hoglet67/HCRMicronPlus/kicad/micron_plus.pdf

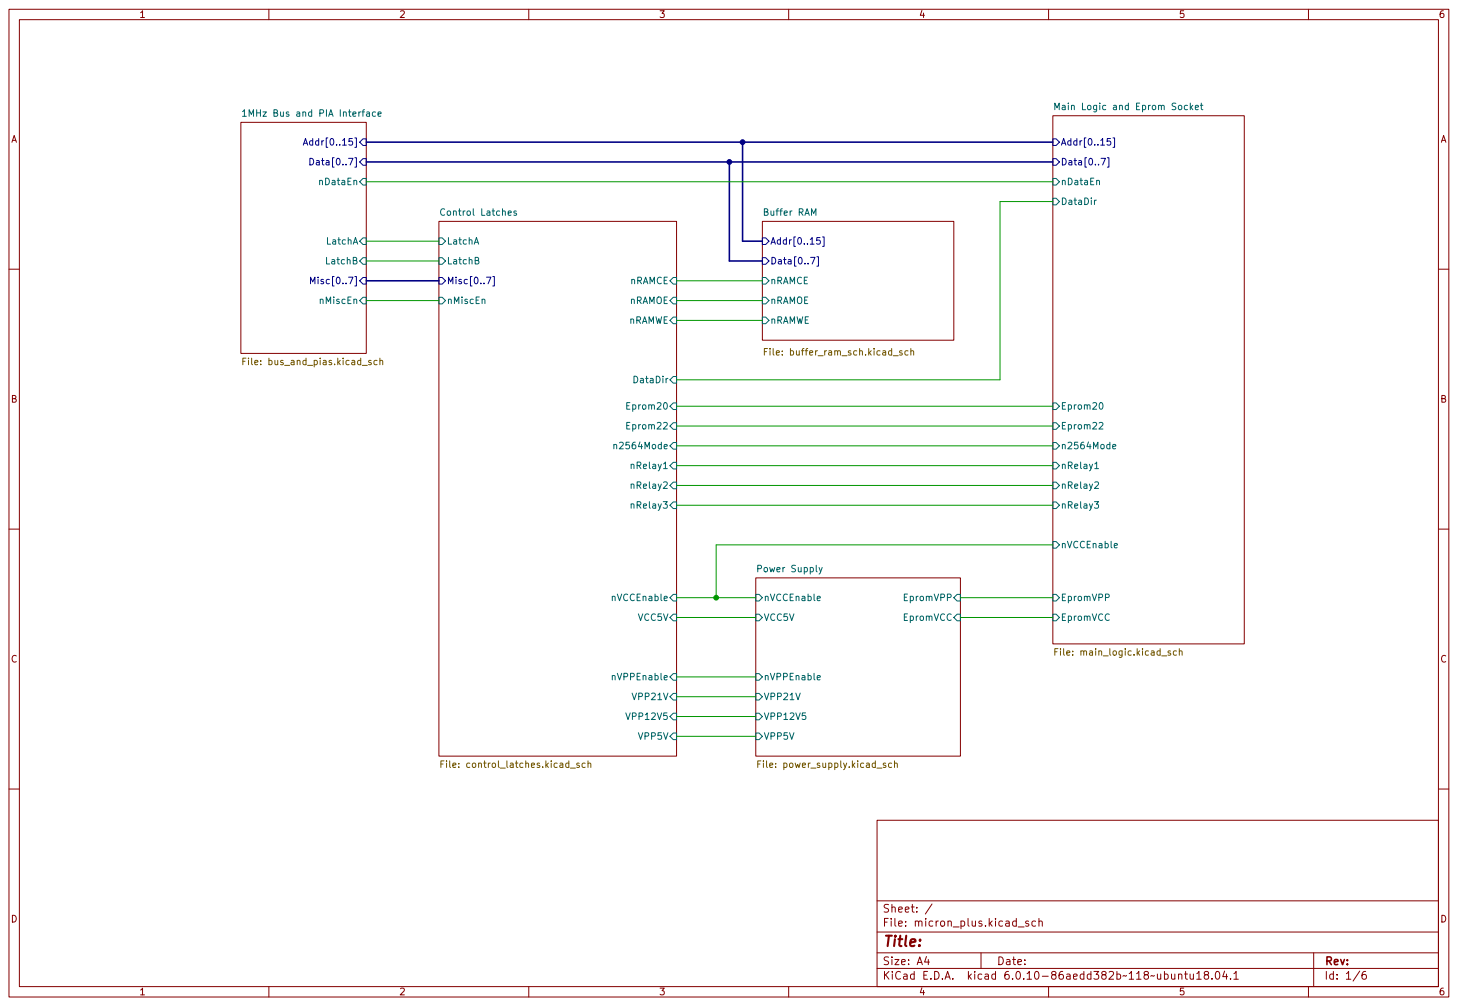
[picture p1: page 1]

nMiscEn Misc[0..7] 1MHz Bus and PIA Interface File: bus_and_pias.kicad_sch
Addr[0..15] nDataEn Data[0..7] LatchA
VCC5V Control Latches File: control_latches.kicad_sch

Main Logic and Eprom Socket
nVCCEnable DataDir n2564Mode

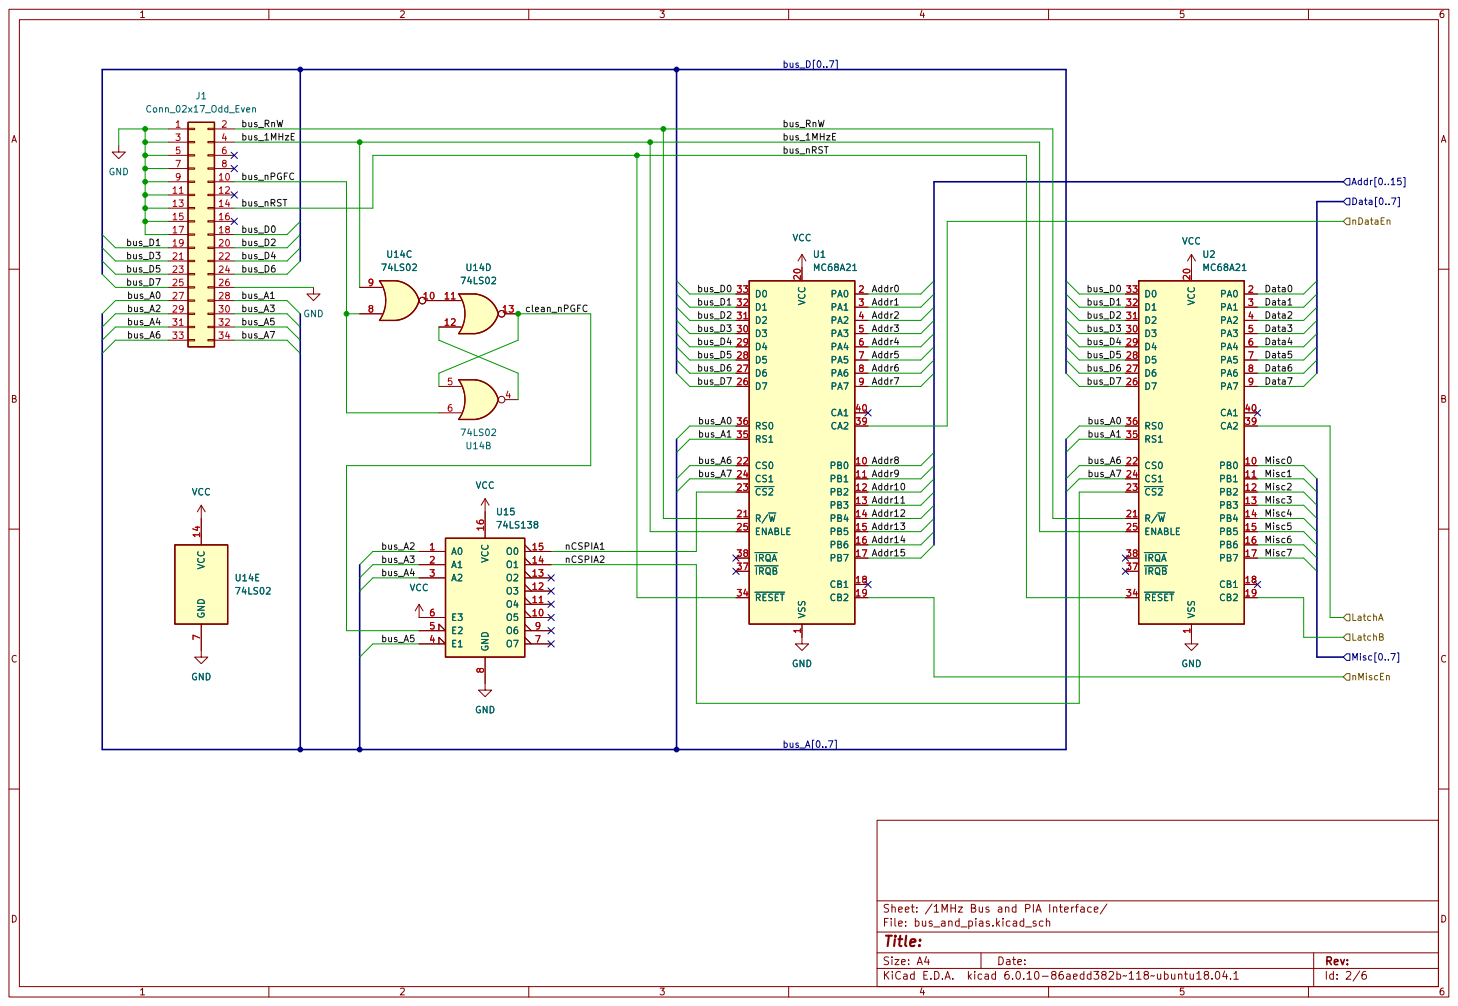
[picture p2: page 2]

bus_RnW

3 | | 4 bus_1MHzE | bus_1MHzE

File: bus_and_pias.kicad_sch Sheet: /1MHz Bus and PIA Interface/
Id: 2/6 Title:

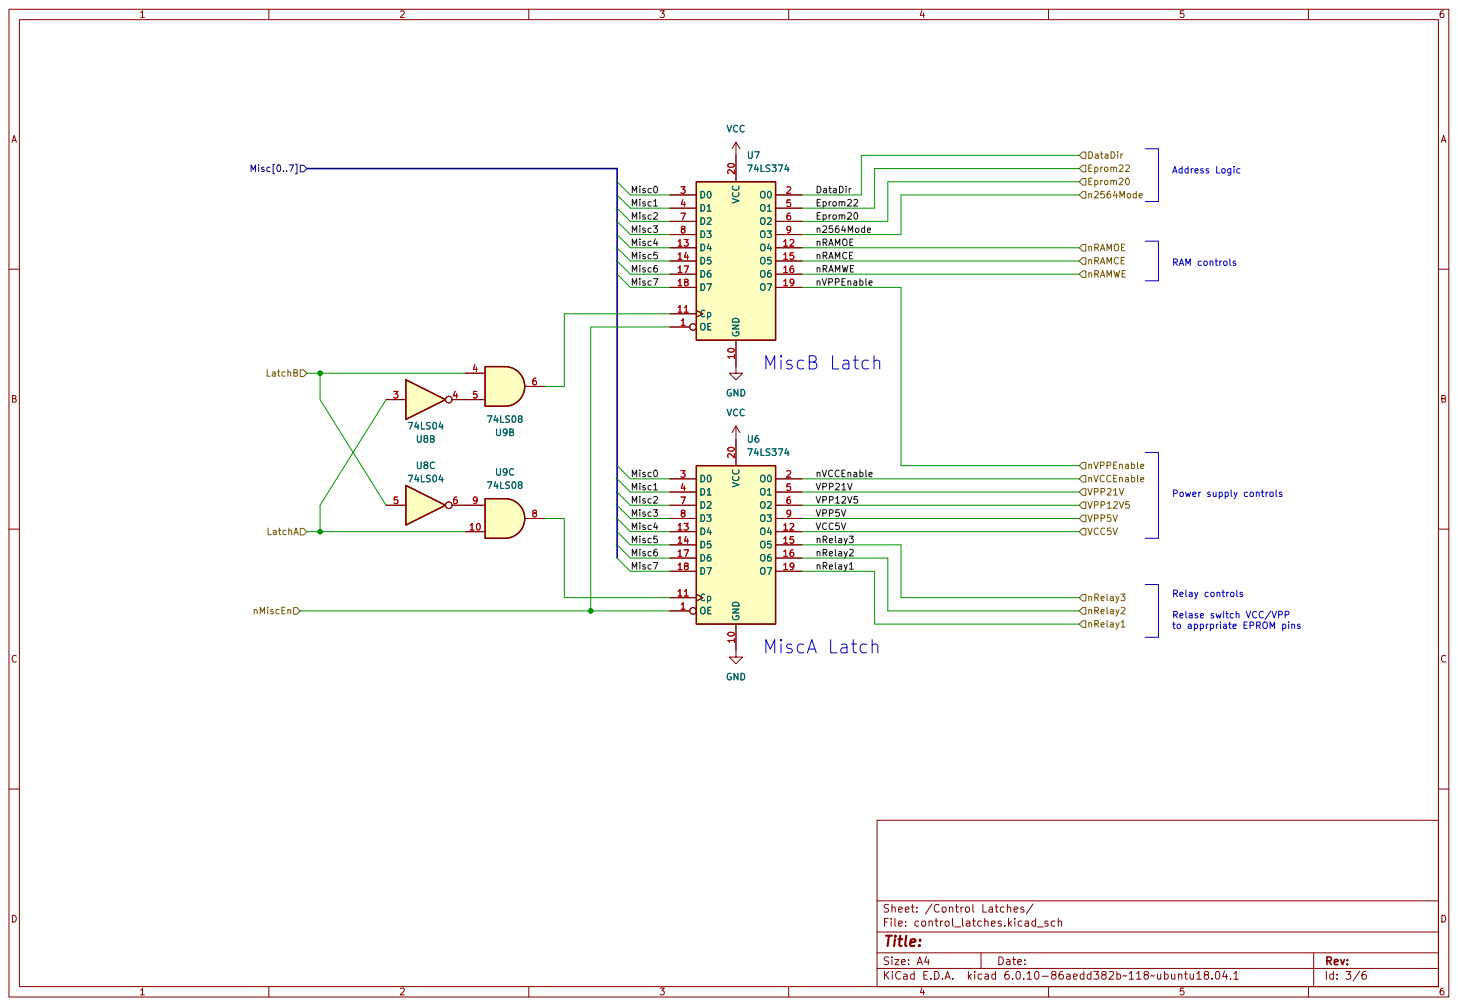
[picture p3: page 3]

RAM controls Address Logic VCC
74LS374 GND

Relay controls Relase switch VCC/VPP

to apprpriate EPROM pins

File: control_latches.kicad_sch Sheet: /Control Latches/
Id: 3/6 Title:

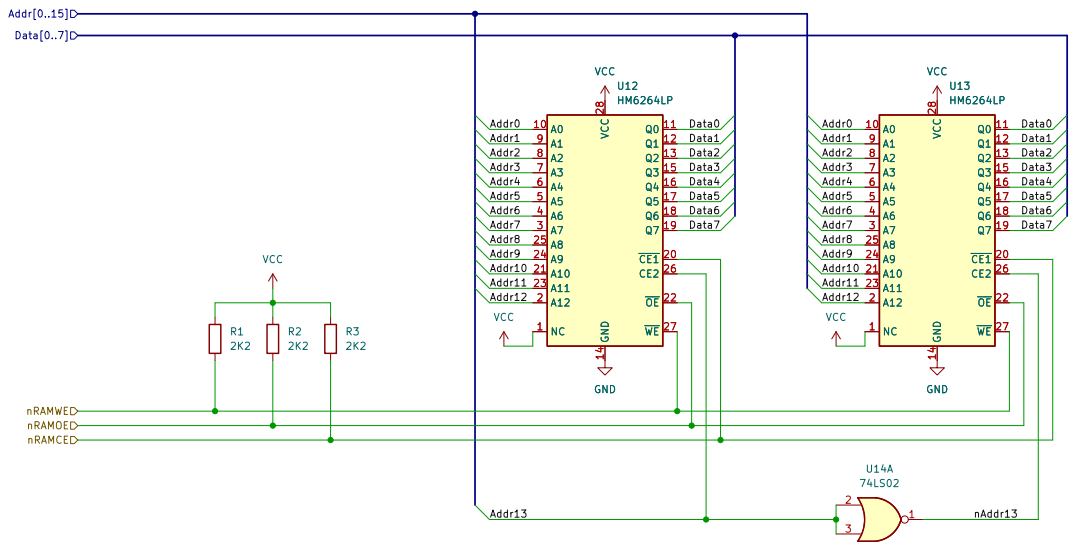
[picture p4: page 4]

File: buffer_ram_sch.kicad_sch Sheet: /Buffer RAM/
Id: 4/6 Title:

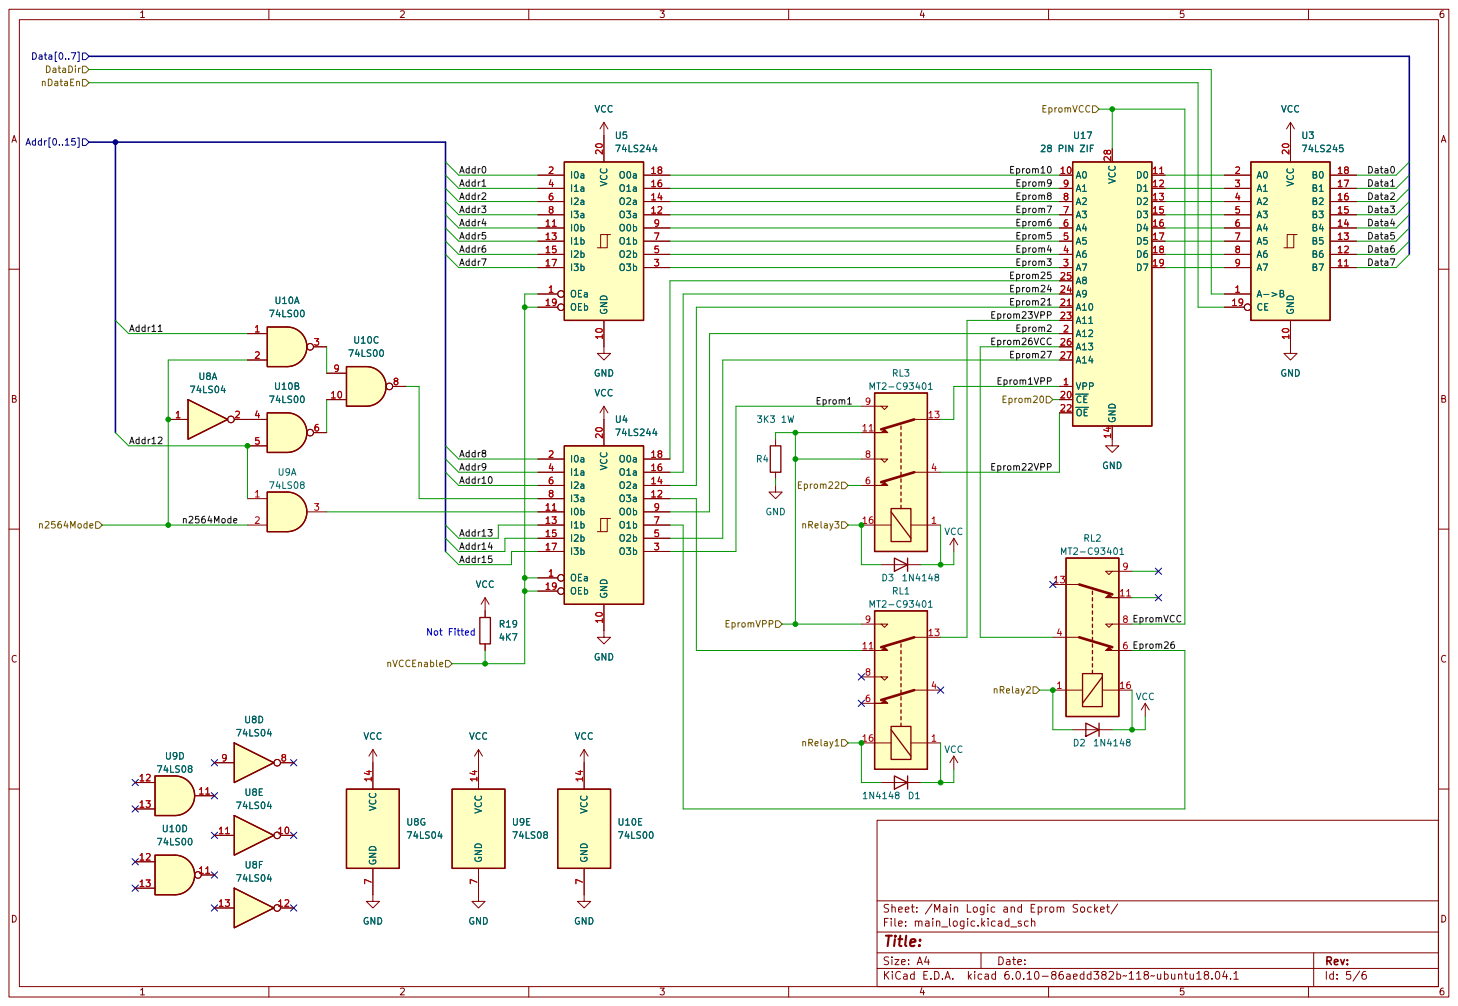
[picture p5: page 5]

Sheet: /Main Logic and Eprom Socket/
File: main_logic.kicad_sch
Id: 5/6 Title:

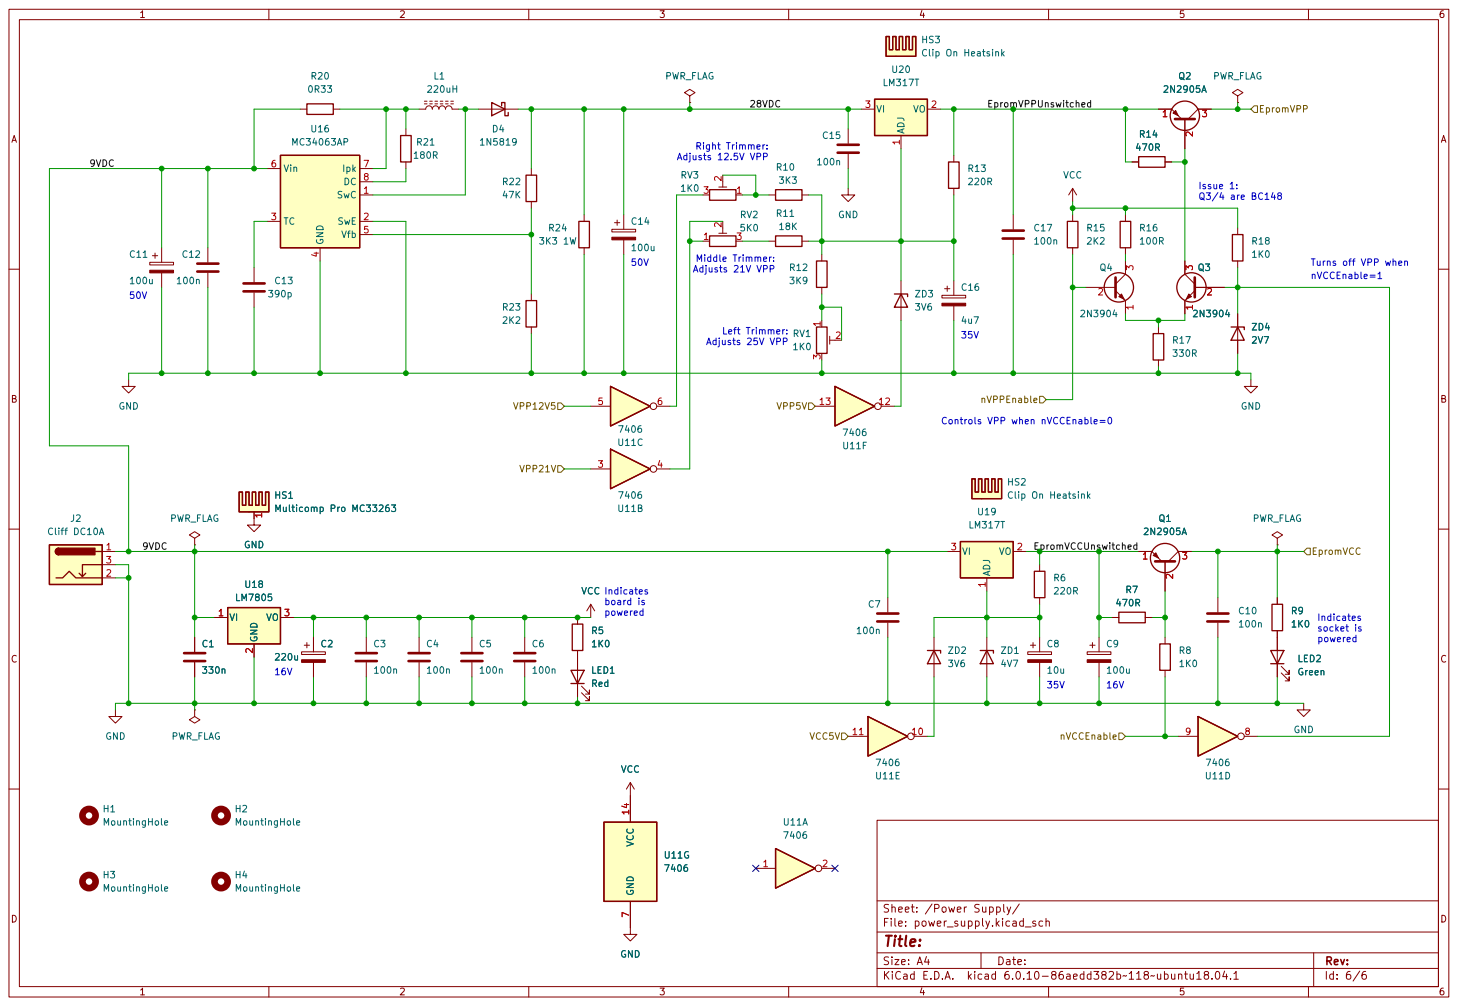
[picture p6: page 6]

Left Trimmer: Adjusts 25V VPP Middle Trimmer: Adjusts 21V VPP
