hoglet67/HCRMicronPlus/kicad/micron_plus.kicad_pcb

## KiCad design kicad/micron_plus.kicad_pcb (2023-11-20)

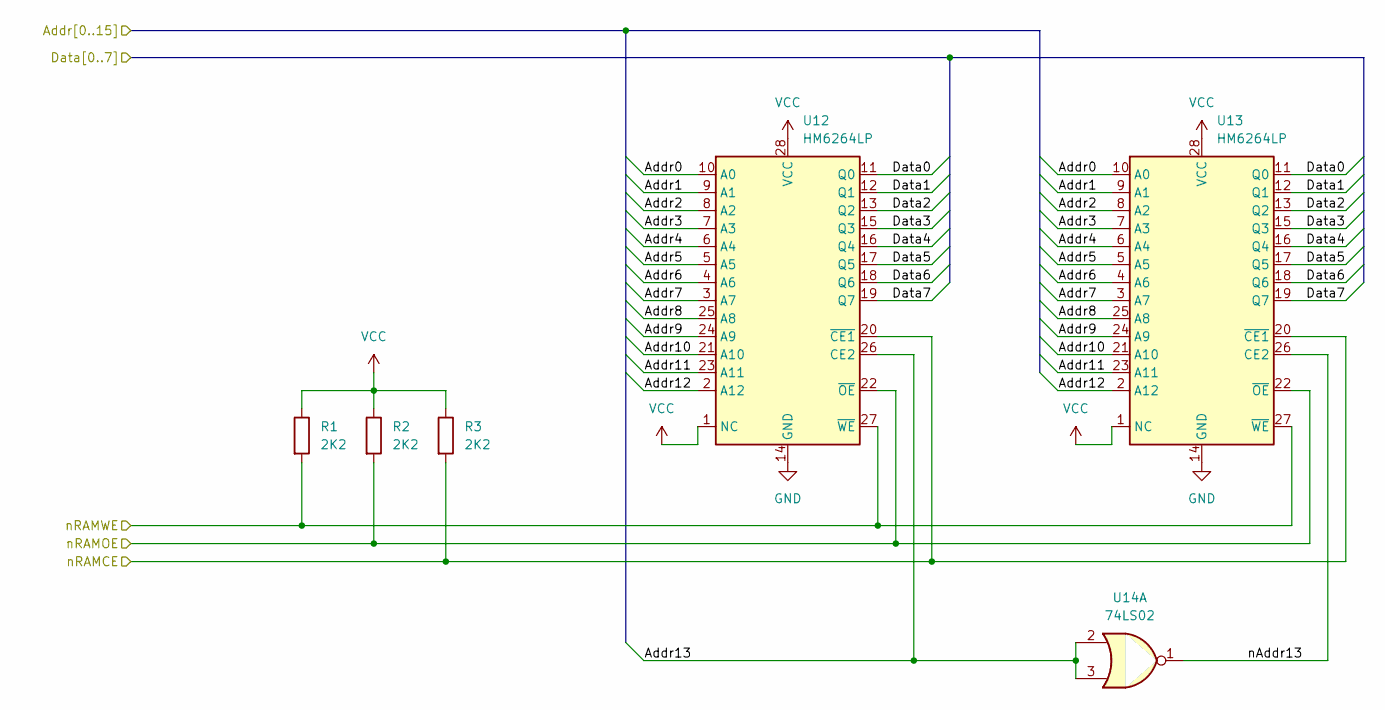
[picture p7: schematic buffer_ram_sch.kicad_sch]

Parts:
R1, R2, R3: 2K2; R_Axial_DIN0207_L6.3mm_D2.0mm_P10.16mm_Horizontal
U12, U13: HM6264LP; DIP-28_W15.24mm_Socket
U14: 74LS02; DIP-14_W7.62mm_Socket

Connections:
/1MHz Bus and PIA Interface/Addr0: U12.10 (A0), U13.10 (A0); also elsewhere on the board
/1MHz Bus and PIA Interface/Addr1: U12.9 (A1), U13.9 (A1); also elsewhere on the board
/1MHz Bus and PIA Interface/Addr2: U12.8 (A2), U13.8 (A2); also elsewhere on the board
/1MHz Bus and PIA Interface/Addr3: U12.7 (A3), U13.7 (A3); also elsewhere on the board
/1MHz Bus and PIA Interface/Addr4: U12.6 (A4), U13.6 (A4); also elsewhere on the board
/1MHz Bus and PIA Interface/Addr5: U12.5 (A5), U13.5 (A5); also elsewhere on the board
/1MHz Bus and PIA Interface/Addr6: U12.4 (A6), U13.4 (A6); also elsewhere on the board
/1MHz Bus and PIA Interface/Addr7: U12.3 (A7), U13.3 (A7); also elsewhere on the board
/1MHz Bus and PIA Interface/Addr8: U12.25 (A8), U13.25 (A8); also elsewhere on the board
/1MHz Bus and PIA Interface/Addr9: U12.24 (A9), U13.24 (A9); also elsewhere on the board
/1MHz Bus and PIA Interface/Addr10: U12.21 (A10), U13.21 (A10); also elsewhere on the board
/1MHz Bus and PIA Interface/Addr11: U12.23 (A11), U13.23 (A11); also elsewhere on the board
/1MHz Bus and PIA Interface/Addr12: U12.2 (A12), U13.2 (A12); also elsewhere on the board
/1MHz Bus and PIA Interface/Addr13: U12.26 (CE2), U14.2, U14.3; also elsewhere on the board
/1MHz Bus and PIA Interface/Data0: U12.11 (Q0), U13.11 (Q0); also elsewhere on the board
/1MHz Bus and PIA Interface/Data1: U12.12 (Q1), U13.12 (Q1); also elsewhere on the board
/1MHz Bus and PIA Interface/Data2: U12.13 (Q2), U13.13 (Q2); also elsewhere on the board
/1MHz Bus and PIA Interface/Data3: U12.15 (Q3), U13.15 (Q3); also elsewhere on the board
/1MHz Bus and PIA Interface/Data4: U12.16 (Q4), U13.16 (Q4); also elsewhere on the board
/1MHz Bus and PIA Interface/Data5: U12.17 (Q5), U13.17 (Q5); also elsewhere on the board
/1MHz Bus and PIA Interface/Data6: U12.18 (Q6), U13.18 (Q6); also elsewhere on the board
/1MHz Bus and PIA Interface/Data7: U12.19 (Q7), U13.19 (Q7); also elsewhere on the board
/Buffer RAM/nAddr13: U13.26 (CE2), U14.1
/Control Latches/nRAMCE: R3.2, U12.20 (~CE1), U13.20 (~CE1); also elsewhere on the board
/Control Latches/nRAMOE: R2.2, U12.22 (~OE), U13.22 (~OE); also elsewhere on the board
/Control Latches/nRAMWE: R1.2, U12.27 (~WE), U13.27 (~WE); also elsewhere on the board
GND: U12.14 (GND), U13.14 (GND); also elsewhere on the board
VCC: R1.1, R2.1, R3.1, U12.1 (NC), U12.28 (VCC), U13.1 (NC), U13.28 (VCC); also elsewhere on the board

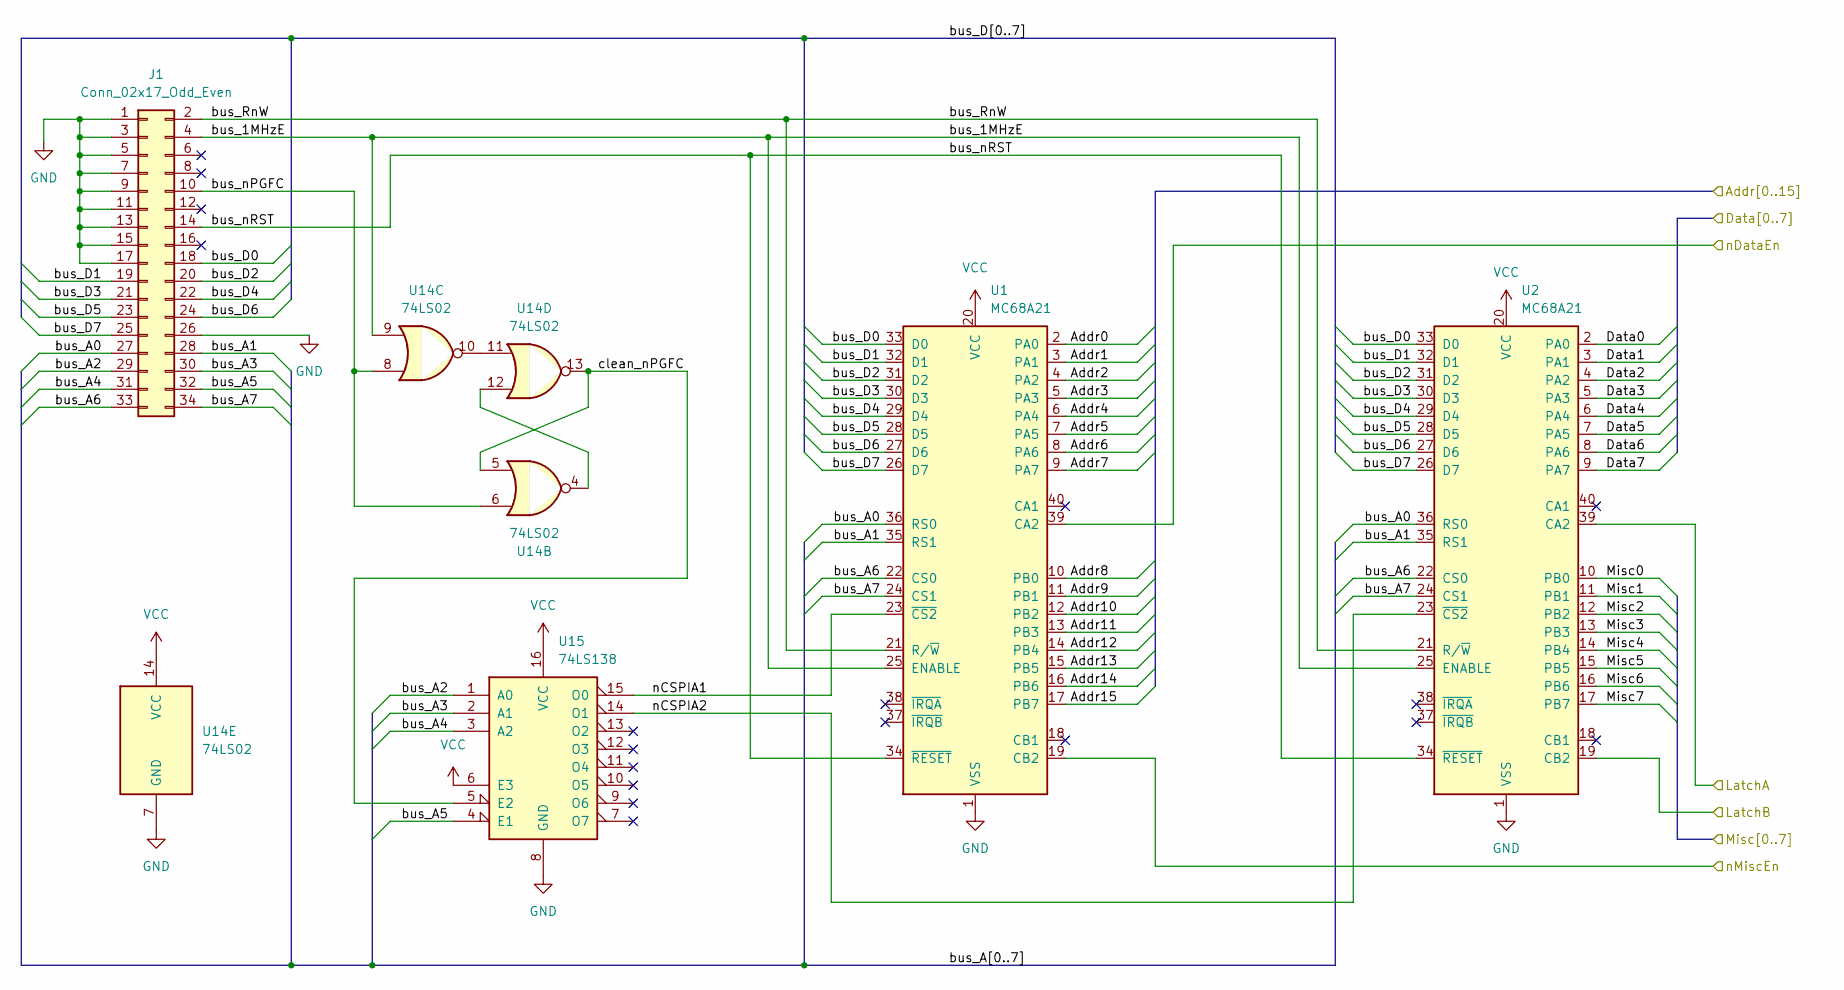
[picture p8: schematic bus_and_pias.kicad_sch]

Parts:
J1: Conn_02x17_Odd_Even; IDC-Header_2x17_P2.54mm_Vertical
U1, U2: MC68A21; DIP-40_W15.24mm_Socket
U14: 74LS02; DIP-14_W7.62mm_Socket
U15: 74LS138; DIP-16_W7.62mm_Socket

Connections:
/1MHz Bus and PIA Interface/Addr0: U1.2 (PA0); also elsewhere on the board
/1MHz Bus and PIA Interface/Addr1: U1.3 (PA1); also elsewhere on the board
/1MHz Bus and PIA Interface/Addr2: U1.4 (PA2); also elsewhere on the board
/1MHz Bus and PIA Interface/Addr3: U1.5 (PA3); also elsewhere on the board
/1MHz Bus and PIA Interface/Addr4: U1.6 (PA4); also elsewhere on the board
/1MHz Bus and PIA Interface/Addr5: U1.7 (PA5); also elsewhere on the board
/1MHz Bus and PIA Interface/Addr6: U1.8 (PA6); also elsewhere on the board
/1MHz Bus and PIA Interface/Addr7: U1.9 (PA7); also elsewhere on the board
/1MHz Bus and PIA Interface/Addr8: U1.10 (PB0); also elsewhere on the board
/1MHz Bus and PIA Interface/Addr9: U1.11 (PB1); also elsewhere on the board
/1MHz Bus and PIA Interface/Addr10: U1.12 (PB2); also elsewhere on the board
/1MHz Bus and PIA Interface/Addr11: U1.13 (PB3); also elsewhere on the board
/1MHz Bus and PIA Interface/Addr12: U1.14 (PB4); also elsewhere on the board
/1MHz Bus and PIA Interface/Addr13: U1.15 (PB5); also elsewhere on the board
/1MHz Bus and PIA Interface/Addr14: U1.16 (PB6); also elsewhere on the board
/1MHz Bus and PIA Interface/Addr15: U1.17 (PB7); also elsewhere on the board
/1MHz Bus and PIA Interface/Data0: U2.2 (PA0); also elsewhere on the board
/1MHz Bus and PIA Interface/Data1: U2.3 (PA1); also elsewhere on the board
/1MHz Bus and PIA Interface/Data2: U2.4 (PA2); also elsewhere on the board
/1MHz Bus and PIA Interface/Data3: U2.5 (PA3); also elsewhere on the board
/1MHz Bus and PIA Interface/Data4: U2.6 (PA4); also elsewhere on the board
/1MHz Bus and PIA Interface/Data5: U2.7 (PA5); also elsewhere on the board
/1MHz Bus and PIA Interface/Data6: U2.8 (PA6); also elsewhere on the board
/1MHz Bus and PIA Interface/Data7: U2.9 (PA7); also elsewhere on the board
/1MHz Bus and PIA Interface/LatchA: U2.39 (CA2); also elsewhere on the board
/1MHz Bus and PIA Interface/LatchB: U2.19 (CB2); also elsewhere on the board
/1MHz Bus and PIA Interface/Misc0: U2.10 (PB0); also elsewhere on the board
/1MHz Bus and PIA Interface/Misc1: U2.11 (PB1); also elsewhere on the board
/1MHz Bus and PIA Interface/Misc2: U2.12 (PB2); also elsewhere on the board
/1MHz Bus and PIA Interface/Misc3: U2.13 (PB3); also elsewhere on the board
/1MHz Bus and PIA Interface/Misc4: U2.14 (PB4); also elsewhere on the board
/1MHz Bus and PIA Interface/Misc5: U2.15 (PB5); also elsewhere on the board
/1MHz Bus and PIA Interface/Misc6: U2.16 (PB6); also elsewhere on the board
/1MHz Bus and PIA Interface/Misc7: U2.17 (PB7); also elsewhere on the board
/1MHz Bus and PIA Interface/bus_1MHzE: J1.4, U1.25 (ENABLE), U2.25 (ENABLE), U14.9
/1MHz Bus and PIA Interface/bus_A0: J1.27, U1.36 (RS0), U2.36 (RS0)
/1MHz Bus and PIA Interface/bus_A1: J1.28, U1.35 (RS1), U2.35 (RS1)
/1MHz Bus and PIA Interface/bus_A2: J1.29, U15.1 (A0)
/1MHz Bus and PIA Interface/bus_A3: J1.30, U15.2 (A1)
/1MHz Bus and PIA Interface/bus_A4: J1.31, U15.3 (A2)
/1MHz Bus and PIA Interface/bus_A5: J1.32, U15.4 (E1)
/1MHz Bus and PIA Interface/bus_A6: J1.33, U1.22 (CS0), U2.22 (CS0)
/1MHz Bus and PIA Interface/bus_A7: J1.34, U1.24 (CS1), U2.24 (CS1)
/1MHz Bus and PIA Interface/bus_D0: J1.18, U1.33 (D0), U2.33 (D0)
/1MHz Bus and PIA Interface/bus_D1: J1.19, U1.32 (D1), U2.32 (D1)
/1MHz Bus and PIA Interface/bus_D2: J1.20, U1.31 (D2), U2.31 (D2)
/1MHz Bus and PIA Interface/bus_D3: J1.21, U1.30 (D3), U2.30 (D3)
/1MHz Bus and PIA Interface/bus_D4: J1.22, U1.29 (D4), U2.29 (D4)
/1MHz Bus and PIA Interface/bus_D5: J1.23, U1.28 (D5), U2.28 (D5)
/1MHz Bus and PIA Interface/bus_D6: J1.24, U1.27 (D6), U2.27 (D6)
/1MHz Bus and PIA Interface/bus_D7: J1.25, U1.26 (D7), U2.26 (D7)
/1MHz Bus and PIA Interface/bus_RnW: J1.2, U1.21 (R/~W), U2.21 (R/~W)
/1MHz Bus and PIA Interface/bus_nPGFC: J1.10, U14.6, U14.8
/1MHz Bus and PIA Interface/bus_nRST: J1.14, U1.34 (~RESET), U2.34 (~RESET)
/1MHz Bus and PIA Interface/clean_nPGFC: U14.5, U14.13, U15.5 (E2)
/1MHz Bus and PIA Interface/nCSPIA1: U1.23 (~CS2), U15.15 (O0)
/1MHz Bus and PIA Interface/nCSPIA2: U2.23 (~CS2), U15.14 (O1)
/1MHz Bus and PIA Interface/nDataEn: U1.39 (CA2); also elsewhere on the board
/1MHz Bus and PIA Interface/nMiscEn: U1.19 (CB2); also elsewhere on the board
GND: J1.1, J1.3, J1.5, J1.7, J1.9, J1.11, J1.13, J1.15, J1.17, J1.26, U1.1 (VSS), U2.1 (VSS), U14.7 (GND), U15.8 (GND); also elsewhere on the board
unnamed: U14.10, U14.11
unnamed: U14.4, U14.12
VCC: U1.20 (VCC), U2.20 (VCC), U14.14 (VCC), U15.6 (E3), U15.16 (VCC); also elsewhere on the board

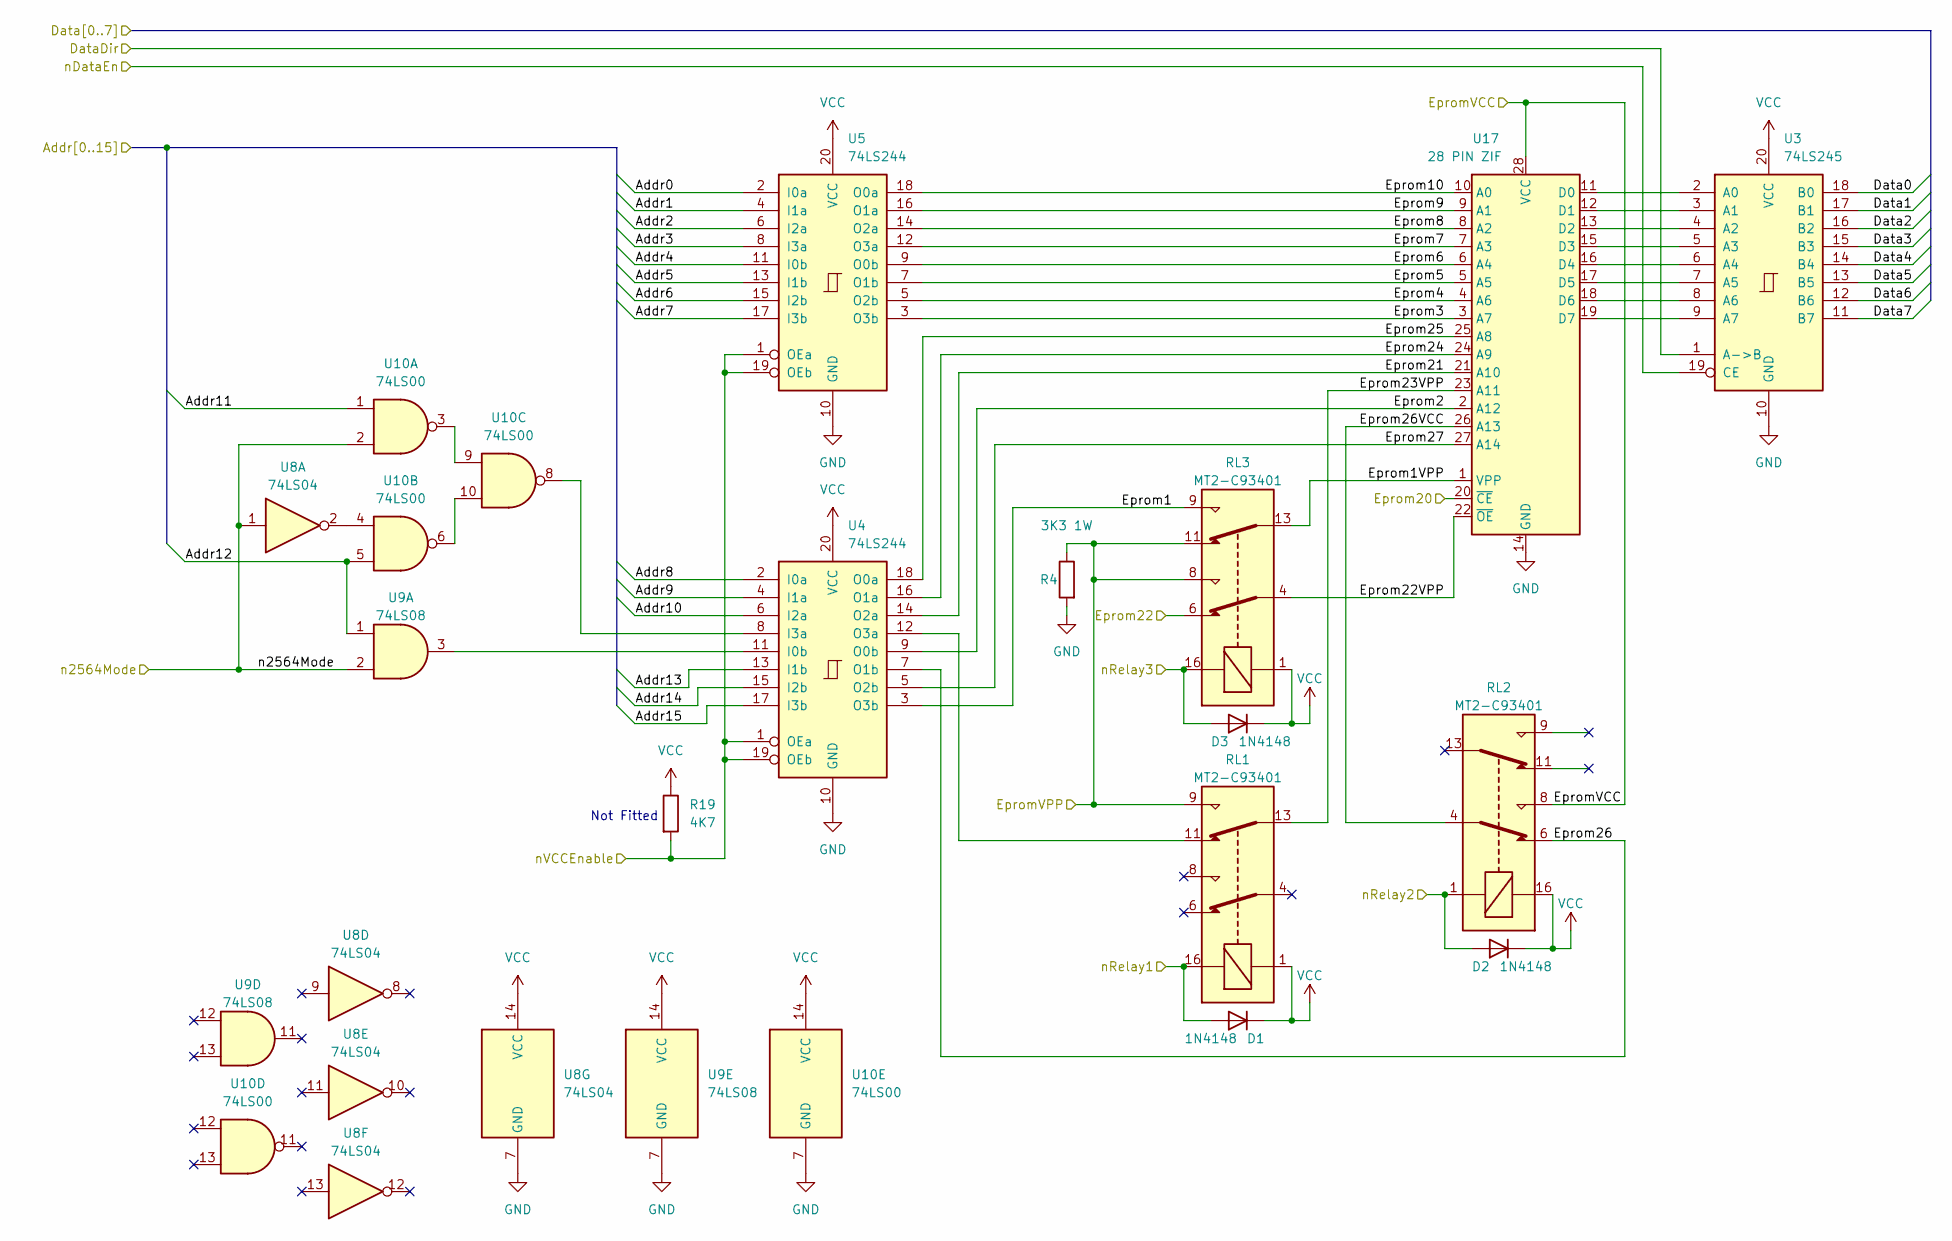
[picture p9: schematic main_logic.kicad_sch]

Parts:
D1, D2, D3: 1N4148; D_DO-35_SOD27_P11.43mm_Horizontal
R4: 3K3 1W; R_Axial_DIN0309_L9.0mm_D3.2mm_P12.70mm_Horizontal
R19: 4K7; R_Axial_DIN0207_L6.3mm_D2.0mm_P10.16mm_Horizontal
RL1, RL2, RL3: MT2-C93401; Relay_DPDT_Omron_G5V-2
U3: 74LS245; DIP-20_W7.62mm_Socket_tweaked
U4, U5: 74LS244; DIP-20_W7.62mm_Socket_tweaked
U8: 74LS04; DIP-14_W7.62mm_Socket
U9: 74LS08; DIP-14_W7.62mm_Socket
U10: 74LS00; DIP-14_W7.62mm_Socket
U17: 28 PIN ZIF; DIP_Socket-28_W11.9_W12.7_W15.24_W17.78_W18.5_3M_228-1277-0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

Connections:
/1MHz Bus and PIA Interface/Addr0: U5.2 (I0a); also elsewhere on the board
/1MHz Bus and PIA Interface/Addr1: U5.4 (I1a); also elsewhere on the board
/1MHz Bus and PIA Interface/Addr2: U5.6 (I2a); also elsewhere on the board
/1MHz Bus and PIA Interface/Addr3: U5.8 (I3a); also elsewhere on the board
/1MHz Bus and PIA Interface/Addr4: U5.11 (I0b); also elsewhere on the board
/1MHz Bus and PIA Interface/Addr5: U5.13 (I1b); also elsewhere on the board
/1MHz Bus and PIA Interface/Addr6: U5.15 (I2b); also elsewhere on the board
/1MHz Bus and PIA Interface/Addr7: U5.17 (I3b); also elsewhere on the board
/1MHz Bus and PIA Interface/Addr8: U4.2 (I0a); also elsewhere on the board
/1MHz Bus and PIA Interface/Addr9: U4.4 (I1a); also elsewhere on the board
/1MHz Bus and PIA Interface/Addr10: U4.6 (I2a); also elsewhere on the board
/1MHz Bus and PIA Interface/Addr11: U10.1; also elsewhere on the board
/1MHz Bus and PIA Interface/Addr12: U9.1, U10.5; also elsewhere on the board
/1MHz Bus and PIA Interface/Addr13: U4.13 (I1b); also elsewhere on the board
/1MHz Bus and PIA Interface/Addr14: U4.15 (I2b); also elsewhere on the board
/1MHz Bus and PIA Interface/Addr15: U4.17 (I3b); also elsewhere on the board
/1MHz Bus and PIA Interface/Data0: U3.18 (B0); also elsewhere on the board
/1MHz Bus and PIA Interface/Data1: U3.17 (B1); also elsewhere on the board
/1MHz Bus and PIA Interface/Data2: U3.16 (B2); also elsewhere on the board
/1MHz Bus and PIA Interface/Data3: U3.15 (B3); also elsewhere on the board
/1MHz Bus and PIA Interface/Data4: U3.14 (B4); also elsewhere on the board
/1MHz Bus and PIA Interface/Data5: U3.13 (B5); also elsewhere on the board
/1MHz Bus and PIA Interface/Data6: U3.12 (B6); also elsewhere on the board
/1MHz Bus and PIA Interface/Data7: U3.11 (B7); also elsewhere on the board
/1MHz Bus and PIA Interface/nDataEn: U3.19 (CE); also elsewhere on the board
/Control Latches/DataDir: U3.1 (A->B); also elsewhere on the board
/Control Latches/Eprom20: U17.20 (~CE); also elsewhere on the board
/Control Latches/Eprom22: RL3.6; also elsewhere on the board
/Control Latches/n2564Mode: U8.1, U9.2, U10.2; also elsewhere on the board
/Control Latches/nRelay1: D1.2 (A), RL1.16; also elsewhere on the board
/Control Latches/nRelay2: D2.2 (A), RL2.1; also elsewhere on the board
/Control Latches/nRelay3: D3.2 (A), RL3.16; also elsewhere on the board
/Control Latches/nVCCEnable: R19.2, U4.1 (OEa), U4.19 (OEb), U5.1 (OEa), U5.19 (OEb); also elsewhere on the board
/Main Logic and Eprom Socket/Eprom1: RL3.9, U4.3 (O3b)
/Main Logic and Eprom Socket/Eprom1VPP: RL3.13, U17.1 (VPP)
/Main Logic and Eprom Socket/Eprom2: U4.9 (O0b), U17.2 (A12)
/Main Logic and Eprom Socket/Eprom3: U5.3 (O3b), U17.3 (A7)
/Main Logic and Eprom Socket/Eprom4: U5.5 (O2b), U17.4 (A6)
/Main Logic and Eprom Socket/Eprom5: U5.7 (O1b), U17.5 (A5)
/Main Logic and Eprom Socket/Eprom6: U5.9 (O0b), U17.6 (A4)
/Main Logic and Eprom Socket/Eprom7: U5.12 (O3a), U17.7 (A3)
/Main Logic and Eprom Socket/Eprom8: U5.14 (O2a), U17.8 (A2)
/Main Logic and Eprom Socket/Eprom9: U5.16 (O1a), U17.9 (A1)
/Main Logic and Eprom Socket/Eprom10: U5.18 (O0a), U17.10 (A0)
/Main Logic and Eprom Socket/Eprom21: U4.14 (O2a), U17.21 (A10)
/Main Logic and Eprom Socket/Eprom22VPP: RL3.4, U17.22 (~OE)
/Main Logic and Eprom Socket/Eprom23VPP: RL1.13, U17.23 (A11)
/Main Logic and Eprom Socket/Eprom24: U4.16 (O1a), U17.24 (A9)
/Main Logic and Eprom Socket/Eprom25: U4.18 (O0a), U17.25 (A8)
/Main Logic and Eprom Socket/Eprom26: RL2.6, U4.7 (O1b)
/Main Logic and Eprom Socket/Eprom26VCC: RL2.4, U17.26 (A13)
/Main Logic and Eprom Socket/Eprom27: U4.5 (O2b), U17.27 (A14)
/Main Logic and Eprom Socket/EpromVCC: RL2.8, U17.28 (VCC); also elsewhere on the board
/Main Logic and Eprom Socket/EpromVPP: R4.1, RL1.9, RL3.8, RL3.11; also elsewhere on the board
GND: R4.2, U3.10 (GND), U4.10 (GND), U5.10 (GND), U8.7 (GND), U9.7 (GND), U10.7 (GND), U17.14 (GND); also elsewhere on the board
unnamed: RL1.11, U4.12 (O3a)
unnamed: U4.11 (I0b), U9.3
unnamed: U10.3, U10.9
unnamed: U8.2, U10.4
unnamed: U4.8 (I3a), U10.8
unnamed: U10.6, U10.10
unnamed: U3.2 (A0), U17.11 (D0)
unnamed: U3.3 (A1), U17.12 (D1)
unnamed: U3.4 (A2), U17.13 (D2)
unnamed: U3.5 (A3), U17.15 (D3)
unnamed: U3.6 (A4), U17.16 (D4)
unnamed: U3.7 (A5), U17.17 (D5)
unnamed: U3.8 (A6), U17.18 (D6)
unnamed: U3.9 (A7), U17.19 (D7)
VCC: D1.1 (K), D2.1 (K), D3.1 (K), R19.1, RL1.1, RL2.16, RL3.1, U3.20 (VCC), U4.20 (VCC), U5.20 (VCC), U8.14 (VCC), U9.14 (VCC), U10.14 (VCC); also elsewhere on the board

Notes on the sheet:
Not Fitted

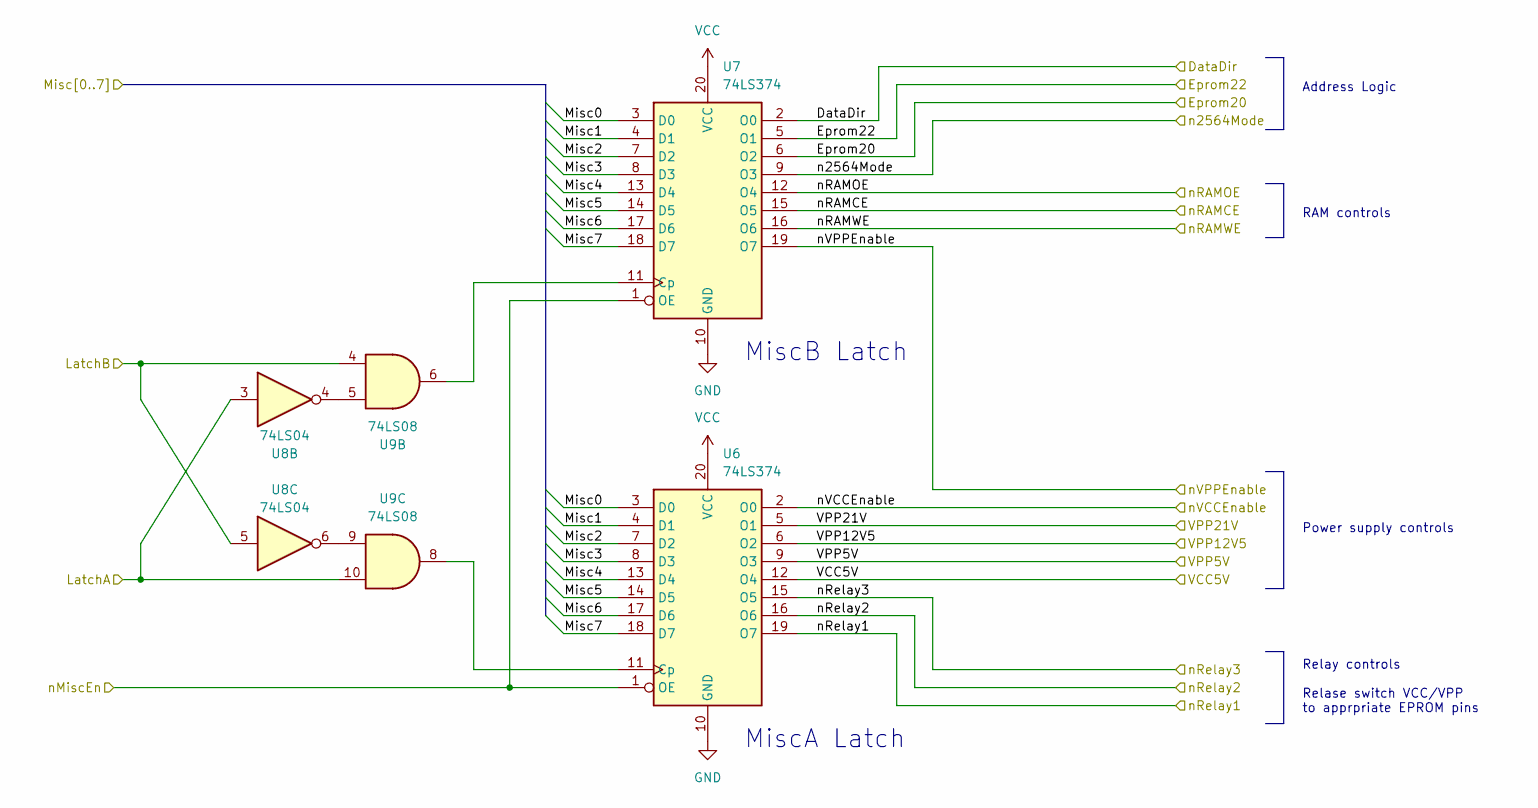
[picture p10: schematic control_latches.kicad_sch]

Parts:
U6, U7: 74LS374; DIP-20_W7.62mm_Socket
U8: 74LS04; DIP-14_W7.62mm_Socket
U9: 74LS08; DIP-14_W7.62mm_Socket

Connections:
/1MHz Bus and PIA Interface/LatchA: U8.3, U9.10; also elsewhere on the board
/1MHz Bus and PIA Interface/LatchB: U8.5, U9.4; also elsewhere on the board
/1MHz Bus and PIA Interface/Misc0: U6.3 (D0), U7.3 (D0); also elsewhere on the board
/1MHz Bus and PIA Interface/Misc1: U6.4 (D1), U7.4 (D1); also elsewhere on the board
/1MHz Bus and PIA Interface/Misc2: U6.7 (D2), U7.7 (D2); also elsewhere on the board
/1MHz Bus and PIA Interface/Misc3: U6.8 (D3), U7.8 (D3); also elsewhere on the board
/1MHz Bus and PIA Interface/Misc4: U6.13 (D4), U7.13 (D4); also elsewhere on the board
/1MHz Bus and PIA Interface/Misc5: U6.14 (D5), U7.14 (D5); also elsewhere on the board
/1MHz Bus and PIA Interface/Misc6: U6.17 (D6), U7.17 (D6); also elsewhere on the board
/1MHz Bus and PIA Interface/Misc7: U6.18 (D7), U7.18 (D7); also elsewhere on the board
/1MHz Bus and PIA Interface/nMiscEn: U6.1 (OE), U7.1 (OE); also elsewhere on the board
/Control Latches/DataDir: U7.2 (O0); also elsewhere on the board
/Control Latches/Eprom20: U7.6 (O2); also elsewhere on the board
/Control Latches/Eprom22: U7.5 (O1); also elsewhere on the board
/Control Latches/VCC5V: U6.12 (O4); also elsewhere on the board
/Control Latches/VPP5V: U6.9 (O3); also elsewhere on the board
/Control Latches/VPP12V5: U6.6 (O2); also elsewhere on the board
/Control Latches/VPP21V: U6.5 (O1); also elsewhere on the board
/Control Latches/n2564Mode: U7.9 (O3); also elsewhere on the board
/Control Latches/nRAMCE: U7.15 (O5); also elsewhere on the board
/Control Latches/nRAMOE: U7.12 (O4); also elsewhere on the board
/Control Latches/nRAMWE: U7.16 (O6); also elsewhere on the board
/Control Latches/nRelay1: U6.19 (O7); also elsewhere on the board
/Control Latches/nRelay2: U6.16 (O6); also elsewhere on the board
/Control Latches/nRelay3: U6.15 (O5); also elsewhere on the board
/Control Latches/nVCCEnable: U6.2 (O0); also elsewhere on the board
/Control Latches/nVPPEnable: U7.19 (O7); also elsewhere on the board
GND: U6.10 (GND), U7.10 (GND); also elsewhere on the board
unnamed: U6.11 (Cp), U9.8
unnamed: U7.11 (Cp), U9.6
unnamed: U8.4, U9.5
unnamed: U8.6, U9.9
VCC: U6.20 (VCC), U7.20 (VCC); also elsewhere on the board

Notes on the sheet:
RAM controls
Address Logic
Power supply controls
MiscA Latch
Relay controls Relase switch VCC/VPP to apprpriate EPROM pins
MiscB Latch

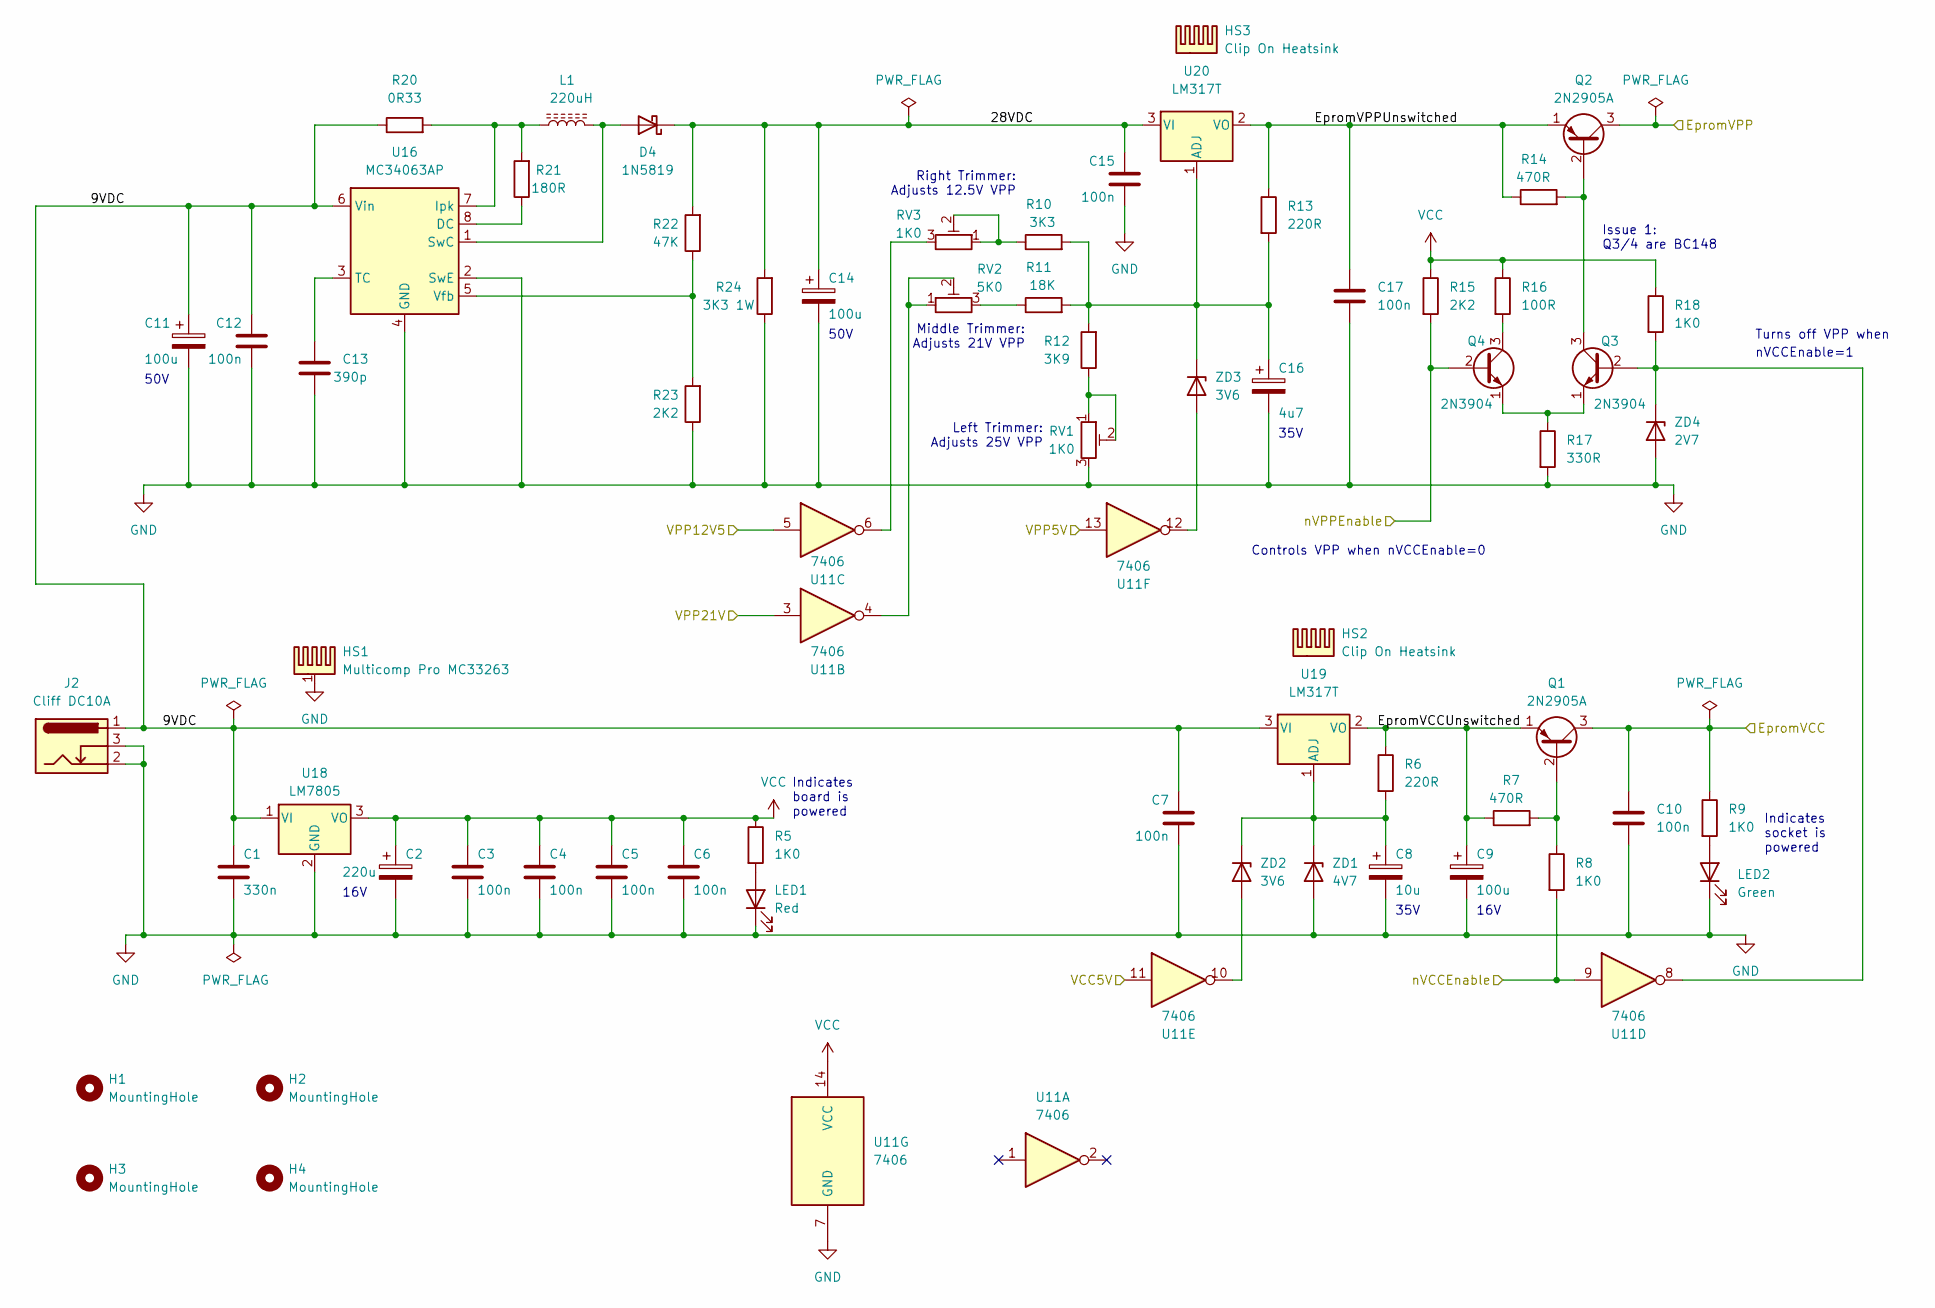
[picture p11: schematic power_supply.kicad_sch]

Parts:
C1: 330n; C_Disc_D4.3mm_W1.9mm_P5.00mm
C2: 220u; CP_Radial_D8.0mm_P5.00mm
C3, C4, C5, C6, C7, C10, C12, C15, C17: 100n; C_Disc_D4.3mm_W1.9mm_P5.00mm
C8: 10u; CP_Radial_Tantal_D4.5mm_P5.00mm
C9: 100u; CP_Radial_D6.3mm_P2.50mm
C11, C14: 100u; CP_Radial_D8.0mm_P5.00mm
C13: 390p; C_Disc_D4.3mm_W1.9mm_P5.00mm
C16: 4u7; CP_Radial_Tantal_D4.5mm_P5.00mm
D4: 1N5819; D_DO-41_SOD81_P10.16mm_Horizontal
H1, H2, H3, H4: MountingHole; MountingHole_3.2mm_M3
HS1: Multicomp Pro MC33263; Heatsink_Fischer_SK104-STC-STIC_35x13mm_2xDrill2.5mm
HS2, HS3: Clip On Heatsink; Heatsink_Boyd_PF720
J2: Cliff DC10A; CLIFF_FC68148(DC-10A)
L1: 220uH; L_Radial_D14.2mm_P10.00mm_Kemet
LED1: Red; LED_D3.0mm
LED2: Green; LED_D3.0mm
Q1, Q2: 2N2905A; TO-39-3
Q3, Q4: 2N3904; TO-92_Wide
R5, R9: 1K0; R_Axial_DIN0207_L6.3mm_D2.0mm_P10.16mm_Horizontal
R6, R13: 220R; R_Axial_DIN0207_L6.3mm_D2.0mm_P11.43mm_Horizontal
R7: 470R; R_Axial_DIN0207_L6.3mm_D2.0mm_P11.43mm_Horizontal
R8, R18: 1K0; R_Axial_DIN0207_L6.3mm_D2.0mm_P11.43mm_Horizontal
R10: 3K3; R_Axial_DIN0207_L6.3mm_D2.0mm_P11.43mm_Horizontal
R11: 18K; R_Axial_DIN0207_L6.3mm_D2.0mm_P11.43mm_Horizontal
R12: 3K9; R_Axial_DIN0207_L6.3mm_D2.0mm_P11.43mm_Horizontal
R14: 470R; R_Axial_DIN0207_L6.3mm_D2.0mm_P10.16mm_Horizontal
R15: 2K2; R_Axial_DIN0207_L6.3mm_D2.0mm_P11.43mm_Horizontal
R16: 100R; R_Axial_DIN0207_L6.3mm_D2.0mm_P11.43mm_Horizontal
R17: 330R; R_Axial_DIN0207_L6.3mm_D2.0mm_P11.43mm_Horizontal
R20: 0R33; R_Axial_DIN0207_L6.3mm_D2.5mm_P10.16mm_Horizontal
R21: 180R; R_Axial_DIN0207_L6.3mm_D2.0mm_P10.16mm_Horizontal
R22: 47K; R_Axial_DIN0207_L6.3mm_D2.0mm_P10.16mm_Horizontal
R23: 2K2; R_Axial_DIN0207_L6.3mm_D2.0mm_P10.16mm_Horizontal
R24: 3K3 1W; R_Axial_DIN0309_L9.0mm_D3.2mm_P12.70mm_Horizontal
RV1, RV3: 1K0; Potentiometer_Bourns_3296W_Vertical
RV2: 5K0; Potentiometer_Bourns_3296W_Vertical
U11: 7406; DIP-14_W7.62mm_Socket
U16: MC34063AP; DIP-8_W7.62mm_Socket
U18: LM7805; TO-220-3_Vertical
U19, U20: LM317T; TO-220-3_Vertical
ZD1: 4V7; D_DO-35_SOD27_P11.43mm_Horizontal
ZD2, ZD3: 3V6; D_DO-35_SOD27_P11.43mm_Horizontal
ZD4: 2V7; D_DO-35_SOD27_P11.43mm_Horizontal

Connections:
/Control Latches/VCC5V: U11.11; also elsewhere on the board
/Control Latches/VPP5V: U11.13; also elsewhere on the board
/Control Latches/VPP12V5: U11.5; also elsewhere on the board
/Control Latches/VPP21V: U11.3; also elsewhere on the board
/Control Latches/nVCCEnable: R8.2, U11.9; also elsewhere on the board
/Control Latches/nVPPEnable: Q4.2 (B), R15.2; also elsewhere on the board
/Main Logic and Eprom Socket/EpromVCC: C10.1, Q1.3 (C), R9.1; also elsewhere on the board
/Main Logic and Eprom Socket/EpromVPP: Q2.3 (C); also elsewhere on the board
/Power Supply/9VDC: C1.1, C7.1, C11.1, C12.1, J2.1, R20.1, U16.6 (Vin), U18.1 (VI), U19.3 (VI)
/Power Supply/28VDC: C14.1, C15.1, D4.1 (K), R22.2, R24.2, U20.3 (VI)
/Power Supply/EpromVCCUnswitched: C9.1, Q1.1 (E), R6.1, R7.1, U19.2 (VO)
/Power Supply/EpromVPPUnswitched: C17.1, Q2.1 (E), R13.1, R14.1, U20.2 (VO)
GND: C1.2, C2.2, C3.2, C4.2, C5.2, C6.2, C7.2, C8.2, C9.2, C10.2, C11.2, C12.2, C13.2, C14.2, C15.2, C16.2, C17.2, HS1.1, J2.2, J2.3, LED1.1 (K), LED2.1 (K), R17.2, R23.1, R24.1, RV1.3, U11.7 (GND), U16.2 (SwE), U16.4 (GND), U18.2 (GND), ZD1.2 (A), ZD4.2 (A); also elsewhere on the board
unnamed: C8.1, R6.2, U19.1 (ADJ), ZD1.1 (K), ZD2.1 (K)
unnamed: C13.1, U16.3 (TC)
unnamed: C16.1, R10.2, R11.2, R12.2, R13.2, U20.1 (ADJ), ZD3.1 (K)
unnamed: D4.2 (A), L1.2, U16.1 (SwC)
unnamed: L1.1, R20.2, R21.2, U16.7 (Ipk)
unnamed: LED1.2 (A), R5.2
unnamed: LED2.2 (A), R9.2
unnamed: Q1.2 (B), R7.2, R8.1
unnamed: Q2.2 (B), Q3.3 (C), R14.2
unnamed: Q3.1 (E), Q4.1 (E), R17.1
unnamed: Q3.2 (B), R18.2, U11.8, ZD4.1 (K)
unnamed: Q4.3 (C), R16.2
unnamed: R10.1, RV3.1, RV3.2
unnamed: R11.1, RV2.3
unnamed: R12.1, RV1.1, RV1.2
unnamed: R21.1, U16.8 (DC)
unnamed: R22.1, R23.2, U16.5 (Vfb)
unnamed: RV2.1, RV2.2, U11.4
unnamed: RV3.3, U11.6
unnamed: U11.10, ZD2.2 (A)
unnamed: U11.12, ZD3.2 (A)
VCC: C2.1, C3.1, C4.1, C5.1, C6.1, R5.1, R15.1, R16.1, R18.1, U11.14 (VCC), U18.3 (VO); also elsewhere on the board

Notes on the sheet:
Left Trimmer: Adjusts 25V VPP
16V
50V
Indicates socket is powered
35V
Indicates board is powered
Controls VPP when nVCCEnable=0
Turns off VPP when
Right Trimmer: Adjusts 12.5V VPP
Middle Trimmer: Adjusts 21V VPP
nVCCEnable=1
Issue 1: Q3/4 are BC148
