hoglet67/HCRMicronPlus/kicad/micron_plus.kicad_pcb

## KiCad design kicad/micron_plus.kicad_pcb (continued)

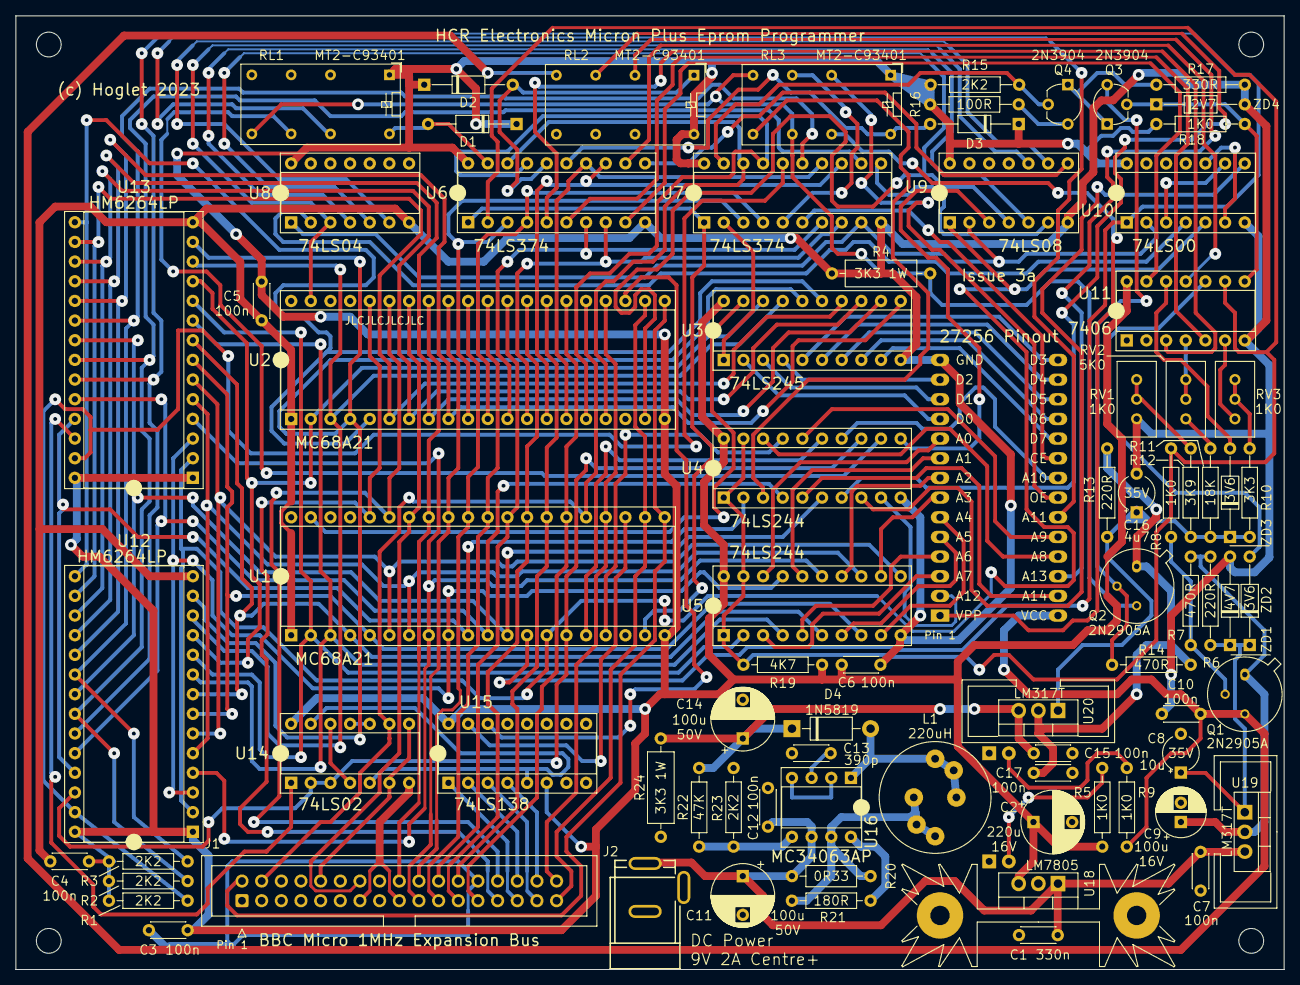
[picture p12: board micron_plus.kicad_pcb from above]

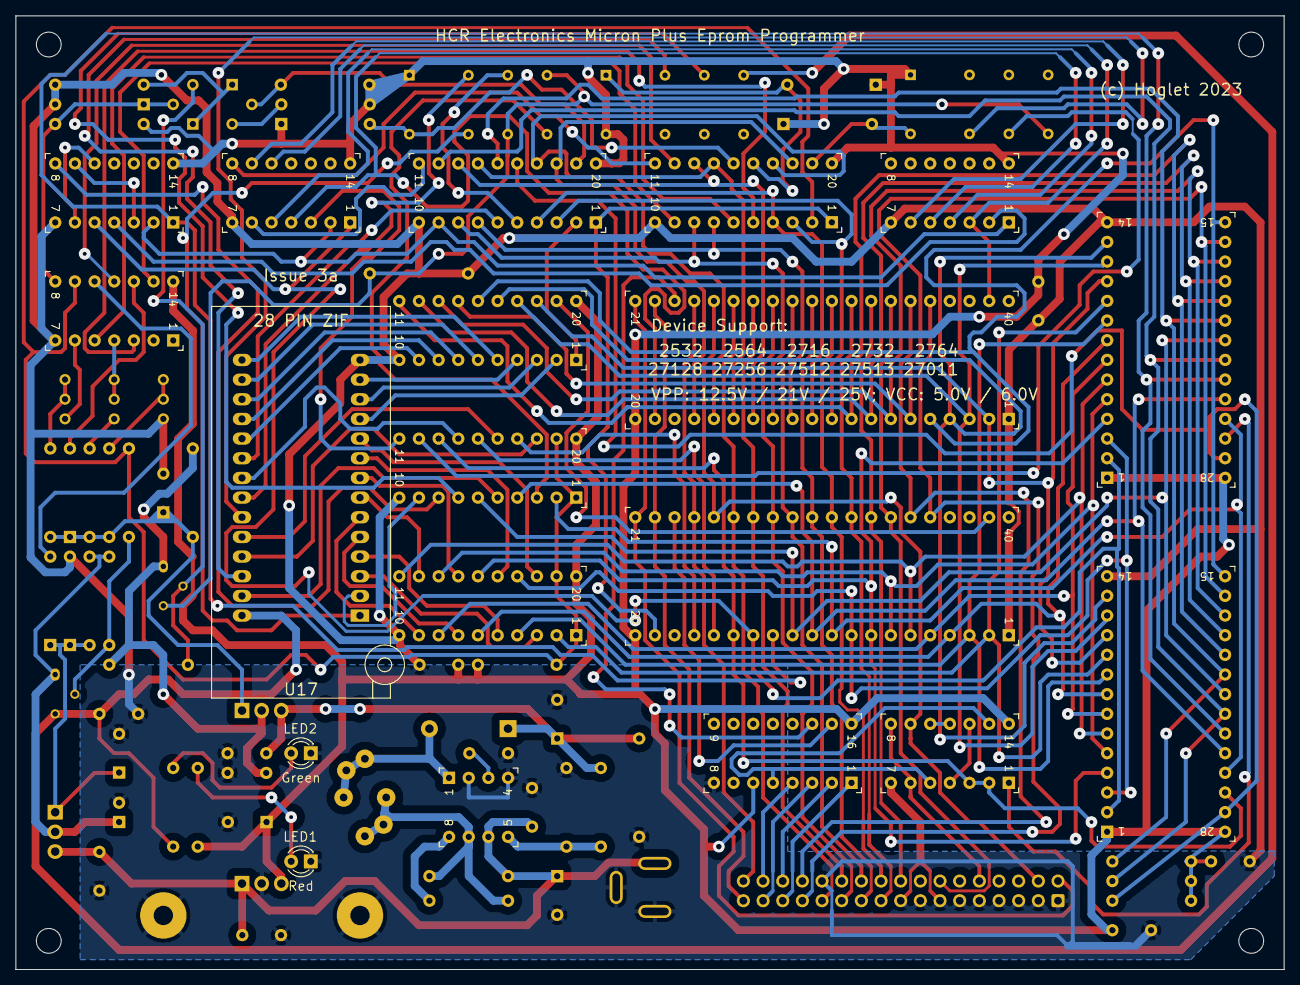
[picture p13: board micron_plus.kicad_pcb from below]

Board: 2 copper layers, 163.8 x 123.2 mm, 91 parts (3 on the bottom side), 144 nets.
