hoglet67/HCRMicronPlus/(commit log)

2023-10-28 Initial KiCAD schematic
    [buffer_ram_sch.kicad_sch, bus_and_pias.kicad_sch, control_latches.kicad_sch, main_logic.kicad_sch, micron_plus.kicad_pcb, micron_plus.kicad_sch, power_supply.kicad_sch]
2023-10-28 Move 7406 onto PSU sheet
    [control_latches.kicad_sch, main_logic.kicad_sch, micron_plus.kicad_sch, power_supply.kicad_sch]
2023-10-28 KiCAD: Use just one nVCCEnable connector on PSU sheet
    [power_supply.kicad_sch]
2023-10-29 Fixed following stardot discussion of PSU, and review of issue 2 photos
    [main_logic.kicad_sch, micron_plus.kicad_sch, power_supply.kicad_sch]
2023-11-01 KiCAD: Initial PCB placement
    [buffer_ram_sch.kicad_sch, bus_and_pias.kicad_sch, control_latches.kicad_sch, main_logic.kicad_sch, micron_plus.kicad_pcb, micron_plus.kicad_sch, power_supply.kicad_sch]
2023-11-04 KiCAD: PCB now routed
    [buffer_ram_sch.kicad_sch, bus_and_pias.kicad_sch, control_latches.kicad_sch, main_logic.kicad_sch, micron_plus.kicad_pcb, micron_plus.kicad_sch, power_supply.kicad_sch]
2023-11-04 KiCAD: Tidying errors/warnings
    [micron_plus.kicad_pcb, micron_plus.kicad_sch, power_supply.kicad_sch]
2023-11-04 KiCAD: Adjust courtyards
    [micron_plus.kicad_pcb, micron_plus.kicad_sch, power_supply.kicad_sch]
2023-11-04 KiCAD: Custom DRC rule to ignore transformer courtyard (for now)
2023-11-04 KiCAD: Added R19 (VCCEnable pullup)
    [main_logic.kicad_sch, micron_plus.kicad_pcb, micron_plus.kicad_sch, power_supply.kicad_sch]
2023-11-08 KiCAD: Replace transition header with normal pin header
    [bus_and_pias.kicad_sch, micron_plus.kicad_pcb, micron_plus.kicad_sch, power_supply.kicad_sch]
2023-11-09 KiCAD: Replace transformer with DC Jack + Boost Converter
    [micron_plus.kicad_pcb, micron_plus.kicad_sch, power_supply.kicad_sch]
2023-11-09 KiCAD: Tweak boost convertor values
    [micron_plus.kicad_sch, power_supply.kicad_sch]
2023-11-09 KiCAD: Add heatsinks
    [micron_plus.kicad_pcb, micron_plus.kicad_sch, power_supply.kicad_sch]
2023-11-09 KiCAD: Trimmers now Bourns 3296W
    [micron_plus.kicad_pcb, micron_plus.kicad_sch, power_supply.kicad_sch]
2023-11-09 KiCAD: Refresh PDF
2023-11-15 KiCAD: Custom footprint for inductor with multiple pads
    [micron_plus.kicad_pcb, micron_plus.kicad_sch, power_supply.kicad_sch]
2023-11-15 KiCAD - silk screen
    [micron_plus.kicad_pcb, micron_plus.kicad_sch, power_supply.kicad_sch]
2023-11-15 KiCAD - more silk screen
    [buffer_ram_sch.kicad_sch, bus_and_pias.kicad_sch, control_latches.kicad_sch, main_logic.kicad_sch, micron_plus.kicad_pcb, micron_plus.kicad_sch, power_supply.kicad_sch]
2023-11-16 KiCAD: Customize IC footprint silk screen
    [buffer_ram_sch.kicad_sch, bus_and_pias.kicad_sch, control_latches.kicad_sch, main_logic.kicad_sch, micron_plus.kicad_pcb, micron_plus.kicad_sch, power_supply.kicad_sch]
2023-11-16 KiCAD: Use 0.95mm holes for ZIF socket
    [main_logic.kicad_sch, micron_plus.kicad_pcb, micron_plus.kicad_sch]
2023-11-16 KiCAD: silk screen
    [micron_plus.kicad_pcb]
2023-11-16 KiCAD: larger footprint for 1W resistors
    [main_logic.kicad_sch, micron_plus.kicad_pcb, micron_plus.kicad_sch, power_supply.kicad_sch]
2023-11-17 KiCAD: Make space for full ZIF
    [main_logic.kicad_sch, micron_plus.kicad_pcb, micron_plus.kicad_sch, power_supply.kicad_sch]
2023-11-17 KiCAD: Add 100n close to MC34063A
    [micron_plus.kicad_pcb, micron_plus.kicad_sch, power_supply.kicad_sch]
2023-11-18 KiCAD: DC Jack now flush with board edge
    [micron_plus.kicad_pcb]
2023-11-18 KiCAD: larger 0R33; silk screen
    [micron_plus.kicad_pcb, micron_plus.kicad_sch, power_supply.kicad_sch]
2023-11-18 KiCAD: Allow space for box header for 1MHz bus
    [bus_and_pias.kicad_sch, micron_plus.kicad_pcb, micron_plus.kicad_sch]
2023-11-18 KiCAD: Tiny tweaks
    [micron_plus.kicad_pcb]
2023-11-19 KiCAD: Improve ground routing
    [micron_plus.kicad_pcb]
2023-11-19 KiCAD: Holes now M3, inset 4.25mm X and 3.7mm Y
    [micron_plus.kicad_pcb, micron_plus.kicad_sch, power_supply.kicad_sch]
2023-11-20 KiCAD: Add JLCJLCJLCJLC
    [micron_plus.kicad_pcb]
2023-11-20 KiCAD: Add (c) Hoglet
    [micron_plus.kicad_pcb]
2023-11-20 KiCAD: Setup Solder Mask Clearance for JLC
    [micron_plus.kicad_pcb]
2023-11-20 KiCAD: Move JLCJLCJLCJLC
    [micron_plus.kicad_pcb]
2023-11-20 KiCAD: Minor silk screen changes
    [micron_plus.kicad_pcb]
2023-11-20 KiCAD: Via holes now 0.5mm/0.7mm
    [micron_plus.kicad_pcb]
2023-11-20 KiCAD: Minor track spacing
    [micron_plus.kicad_pcb]
2023-11-20 KiCAD: Reverse D1/2
    [main_logic.kicad_sch, micron_plus.kicad_pcb]
2023-11-20 KiCAD: Increase ZIF hole size to 0.95mm
    [micron_plus.kicad_pcb]
2023-11-20 KiCAD: Add gerbers
    [micron_plus-B_Cu.gbl, micron_plus-B_Mask.gbs, micron_plus-B_Silkscreen.gbo, micron_plus-Edge_Cuts.gm1, micron_plus-F_Cu.gtl, micron_plus-F_Mask.gts, micron_plus-F_Silkscreen.gto, micron_plus-NPTH-drl_map.gbr]
2023-12-06 Firmware: Correctly sequence VCC/VPP for 24-pin EPROMs
    [hcr.asm]
